ishaanbhimani0628/EE475_Team7/README.md

# EE475 Team 7

Embedded Systems Capstone project by Hafsa Khan, Ishaan Bhimani, Tanpreet Plaha.
