ishaanbhimani0628/EE475_Team7/docs/n04_rapidprototype.md

---
layout: page
title: Prototype
---

## Mechanical Design and Sketches
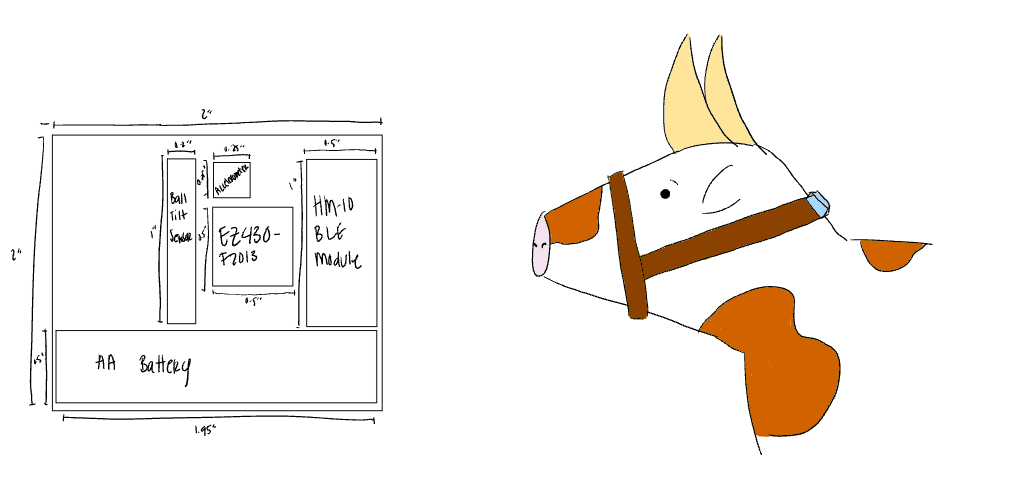
[picture p10: docs/PrototypeImages/animal_sketch.PNG]
Collar Design

Collar Design
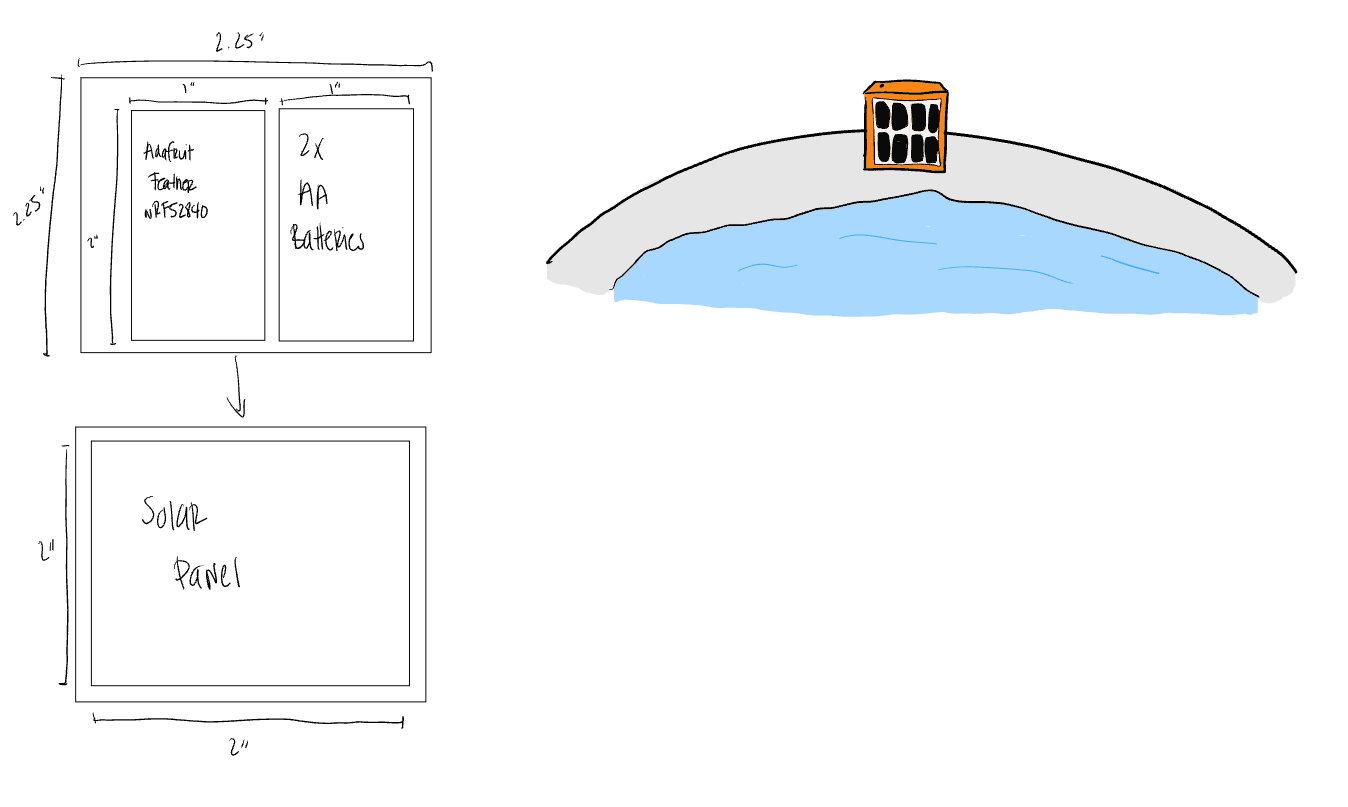
[picture p11: docs/PrototypeImages/base_station_sketch.PNG]
Base Station Design

Base Station Design

## Schematics 
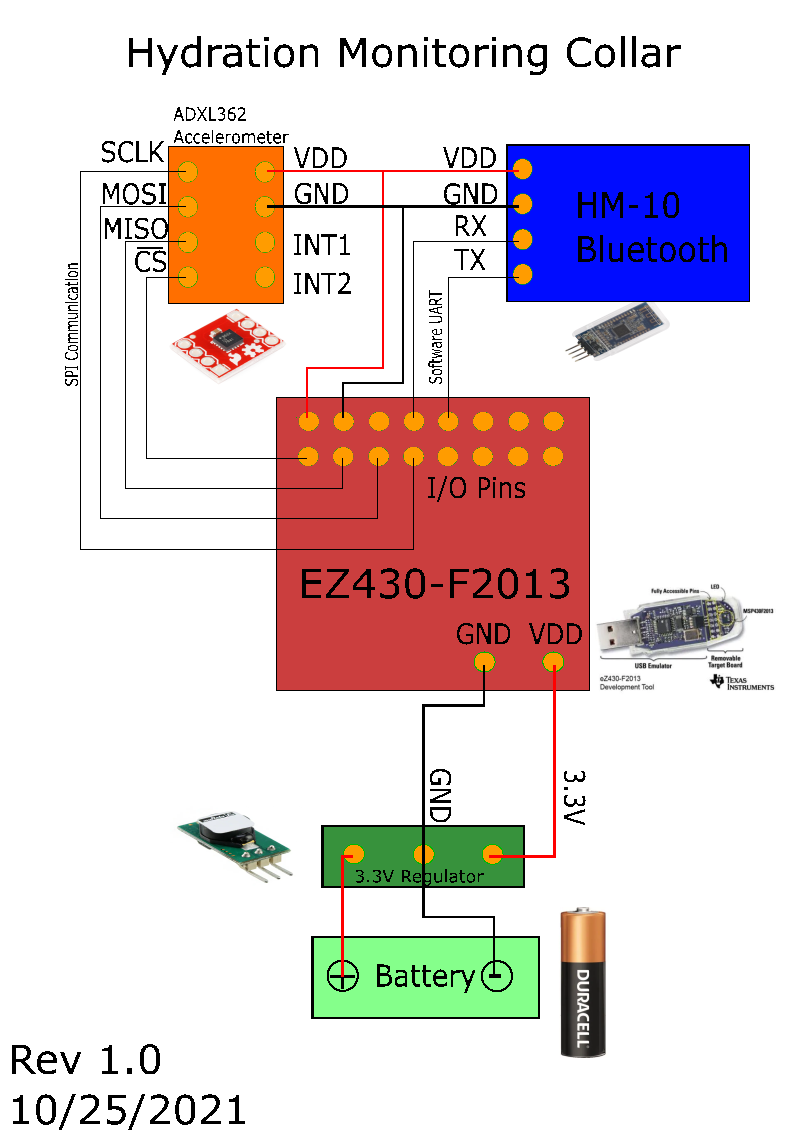
[picture p12: docs/PrototypeImages/collar_schematic.png]
Collar Schematic

Collar Schematic
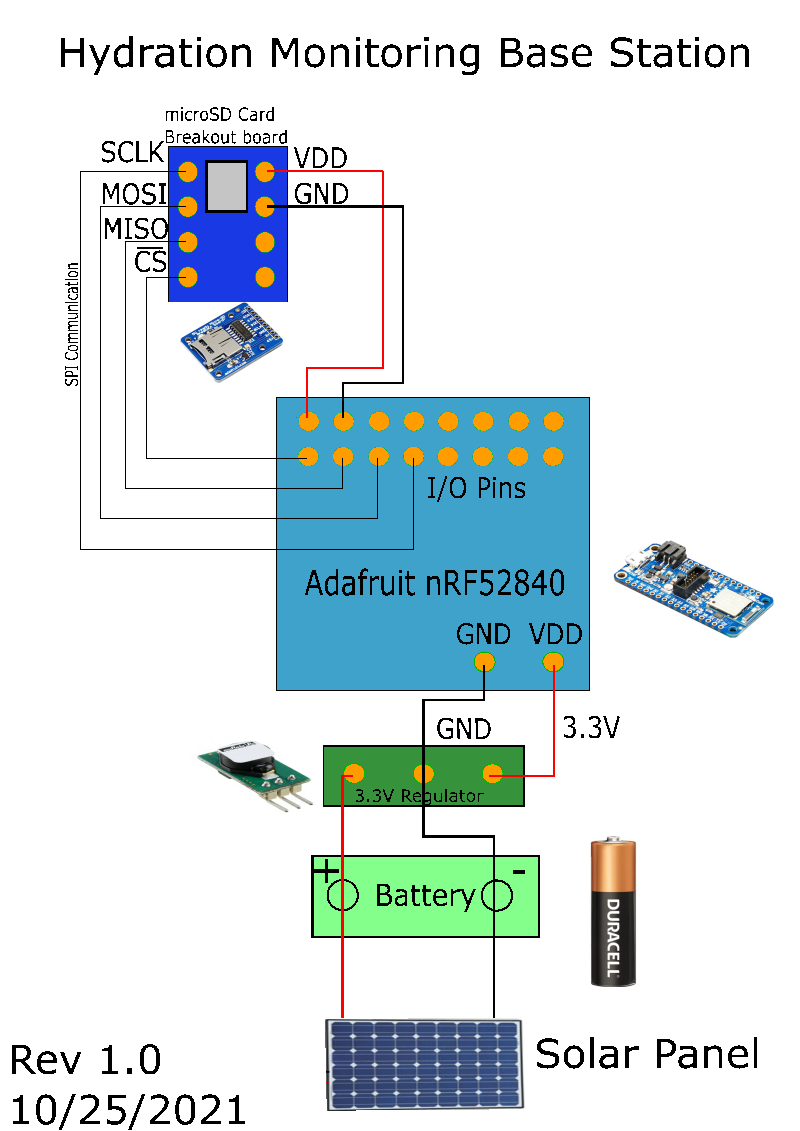
[picture p13: docs/PrototypeImages/base_station_schematic.png]
Base Station Schematic

Base Station Schematic

## App Sketches
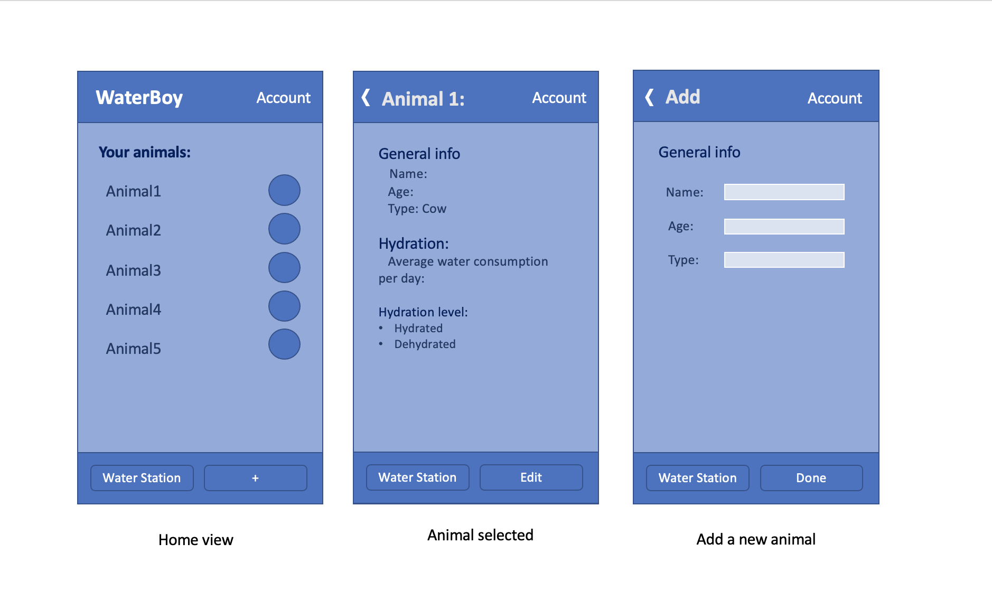
[picture p14: docs/PrototypeImages/app_mockup1.png]
App Mockup 1

App Mockup
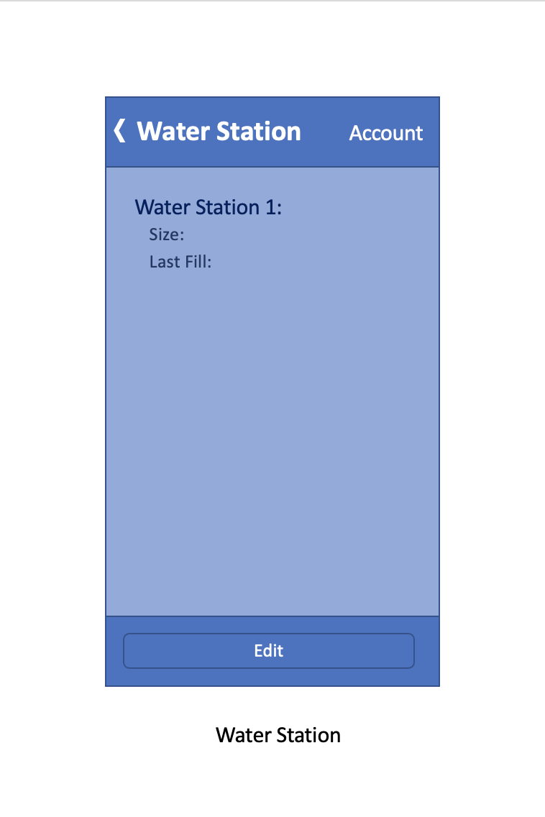
[picture p15: docs/PrototypeImages/app_mockup2.png]
App Mockup 2

App Mockup
