ishaanbhimani0628/EE475_Team7/(list of files, drawings)

Other design files:
pcb/475_PCB_Collar.PrjPcb
pcb/Collar.PcbDoc
pcb/Collar.SchDoc
pcb/WaterBoy_Library.PcbLib
pcb/Waterboy_Library.SchLib
