ishaanbhimani0628/EE475_Team7/nano/nano_BLE/connectToPhone.ino.ino

void updateDataLevel() {
  /* Read the current voltage level on the A0 analog input pin.
     This is used here to simulate the charge level of a battery.
  */
  Serial.print("Sending Data: ");
  //Serial.println(dummy);
  String data_str = String(total_time/1000);
  int str_len = data_str.length();
  byte data_arr[str_len];
  const char* data_c_str = data_str.c_str();
  for(int i = 0; i < str_len; i++){
    data_arr[i] = data_c_str[i];
  }
  dataChar.writeValue(data_arr, str_len);  // and update the battery level characteristic
  total_time_prev = total_time;
  Serial.println(data_c_str);
}

void waitForConnection() {
  int updated = 0;
  int waitTime = millis();
  Serial.println("Waiting for phone to connect");// wait for a BLE central
  while (millis() - waitTime < 30000) { //wait a maximum of 30 seconds.
    BLEDevice central = BLE.central();
    // if a central is connected to the peripheral:
    if (central) {
      Serial.print("Connected to phone: ");
      //connectNum++;
      // print the central's BT address:
      //Serial.println(central.address());
      // turn on the LED to indicate the connection:
      //digitalWrite(LED_BUILTIN, HIGH);
  
      // check the battery level every 200ms
      // while the central is connected:
      while (central.connected()) {
        long currentMillis = millis();
        // if 200ms have passed, check the battery level:
        if (currentMillis - previousMillis >= 200) {
            updateDataLevel();
        }
      }
      // when the central disconnects, turn off the LED:
      //digitalWrite(LED_BUILTIN, LOW);
      Serial.print("Disconnected from phone: ");
      //Serial.println(central.address());
    }
  }
}
