ishaanbhimani0628/EE475_Team7/(commit log)

2021-10-26 added rapid prototype
2021-10-26 Rapid prototype update
2021-11-04 added uart files
2021-11-08 preliminary spi code. works with oscilloscope but having trouble interfacing with ADXL362
2021-11-08 change SPI CPOL and CPHA to 0, successfully reading X axis, but not other axes
2021-11-15 collar code with spi and uart
2021-11-25 first draft of whole system schematic
    [Collar.PcbDoc, Collar.SchDoc, WaterBoy_Library.PcbLib, Waterboy_Library.SchLib]
2021-11-25 fix collar schematic footprint problem
    [Collar.PcbDoc, Collar.SchDoc]
2021-11-25 start pcb layout
    [475_PCB_Collar.PrjPcb, Collar.PcbDoc, Collar.SchDoc]
2021-11-28 add rssi reading for Arduino
2021-11-28 rough PCB layout, still need to make power pours, set rules, etc. Consider swapping Rx and Tx for BLE
    [475_PCB_Collar.PrjPcb, Collar.PcbDoc]
2021-11-29 schematic finalization and PCB design for review. Especially check clearances between components
    [Collar.PcbDoc, Collar.SchDoc]
2021-11-29 add ground plane cutout under boost converter to decrease capacitance around switching node
    [Collar.PcbDoc]
2021-11-29 make switch node cutout
    [Collar.PcbDoc]
2021-12-04 working base station code, may need tweaking
    [Collar.PcbDoc]
2021-12-10 fix code after demo...
    [connectToHM10.ino]
2021-12-13 minor change to battery life :(
2021-12-13 update battery life :(
